Padimo/bioimpedance/pcb.jpg

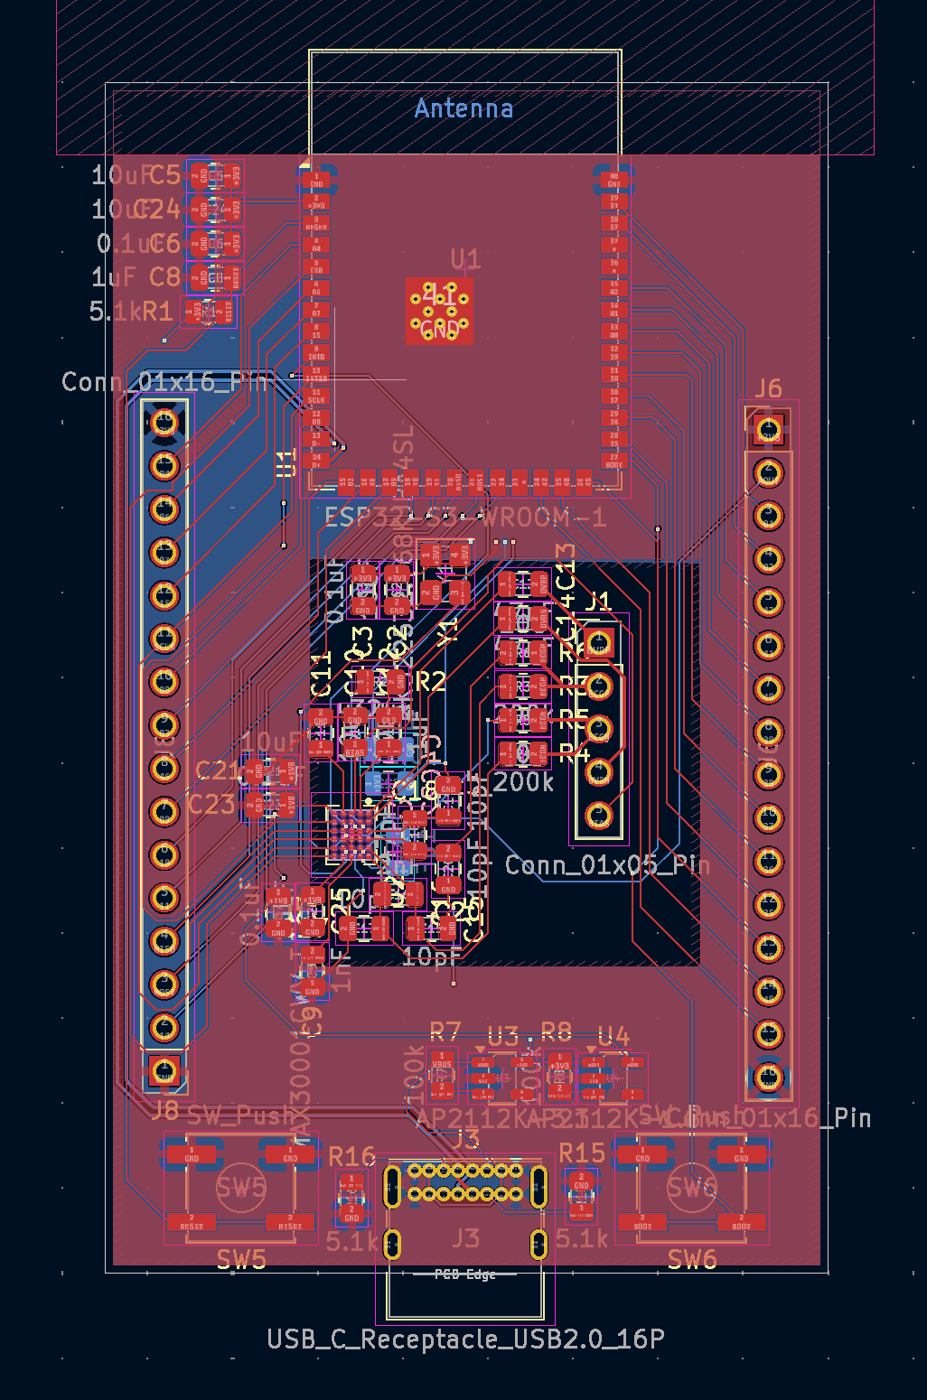
pcb.jpg
