Padimo/bioimpedance/rend1.jpg

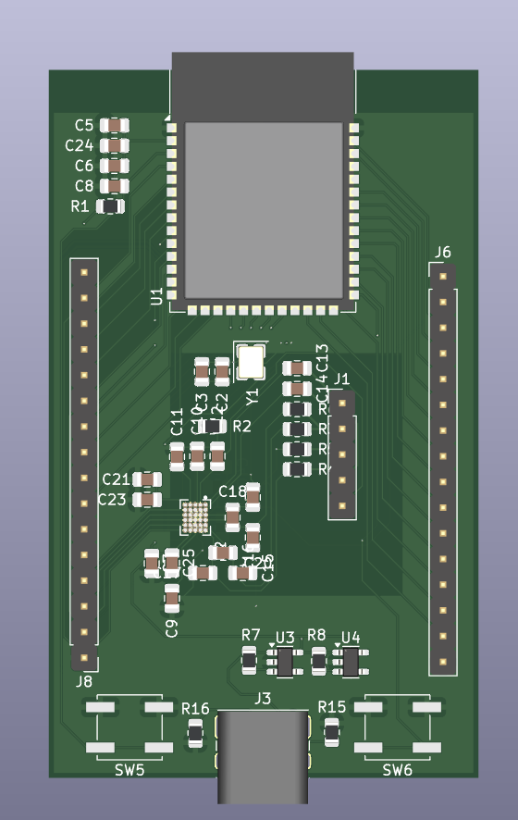
rend1.jpg
