Padimo/bioimpedance/rend1.png

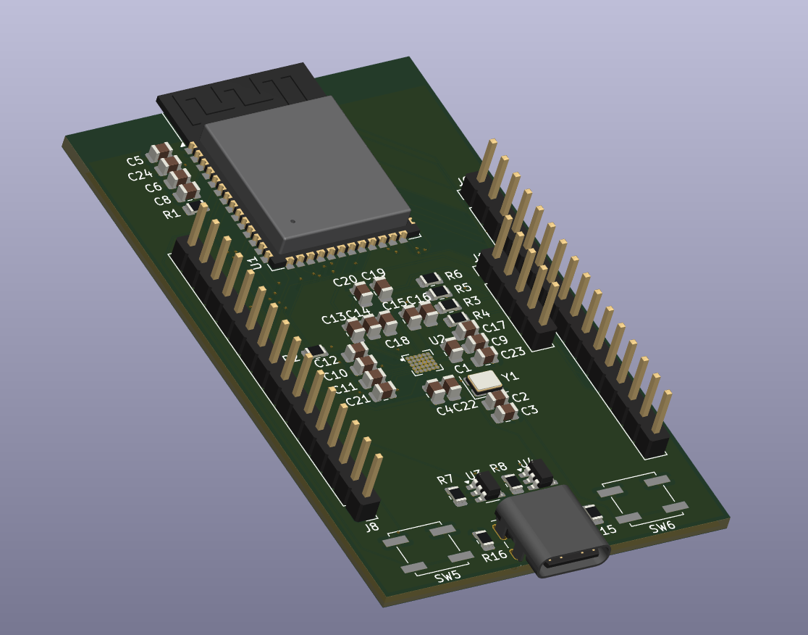
rend1.png
