Padimo/bioimpedance/rend2.jpg

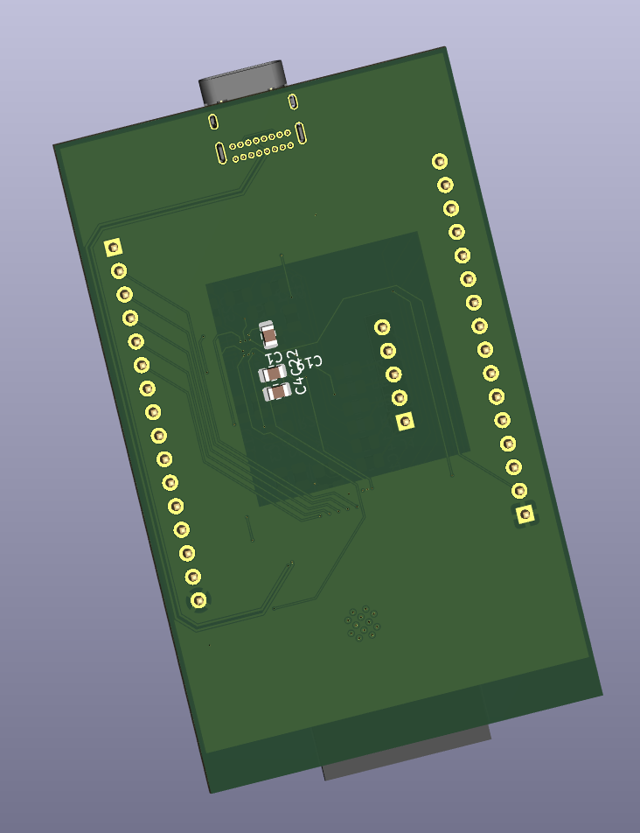
rend2.jpg
