Padimo/bioimpedance/production/JLC_BOM.xlsx

Comment | Designator | Footprint | JLCPCB Part #（optional）
ESPRESSIF ESP32-S3-WROOM-1-N8 | U1 | ESP32-S3-WROOM-1 | C2913199
USB C | J3 | USB_C_Receptacle_GCT_USB4085 | C7095263
Push button | SW5,SW6 | SW_Push_1P1T_NO_CK_KSC6xxJ | C2888743
Oscillator 32kHz | Y1 | Crystal_SMD_3225_4Pin_3.2x2.5mm | C725996
MAX30001 | U2 | BGA30N50P5X6_274X292X69N | C2650384
1.8V regulator | U4 | SOT-25-5 | C176944
3.3V regulator | U3 | SOT-25-5 | C51118
10uF | C2,C4,C5,C10,C11,C21,C24,C25 |  | C1713
1uF | C1,C8,C12 |  | C1712
0.1uF | C3,C6,C7,C22,C23 |  | C1711
1nF | C9 |  | C46653
47nF | C13,C14 |  | C1744
2nF | C16 |  | C28260
47pF | C18 |  | C14857
10pF | C15,C17,C19,C20 |  | C107107
5.1k | R1,R15,R16 |  | C27834
324k | R2 |  | C17626
200k | R3,R4 |  | C17539
200 | R5,R6 |  | C17540
100k | R7,R8 |  | C25611
