Padimo/bioimpedance/(list of files, drawings)

Other design files:
pcb/freerouting.dsn
pcb/temp-freerouting.dsn
