Padimo/bioimpedance/pcb/bioimpedance.kicad_pcb

## KiCad design pcb/bioimpedance.kicad_pcb (2025-08-21)

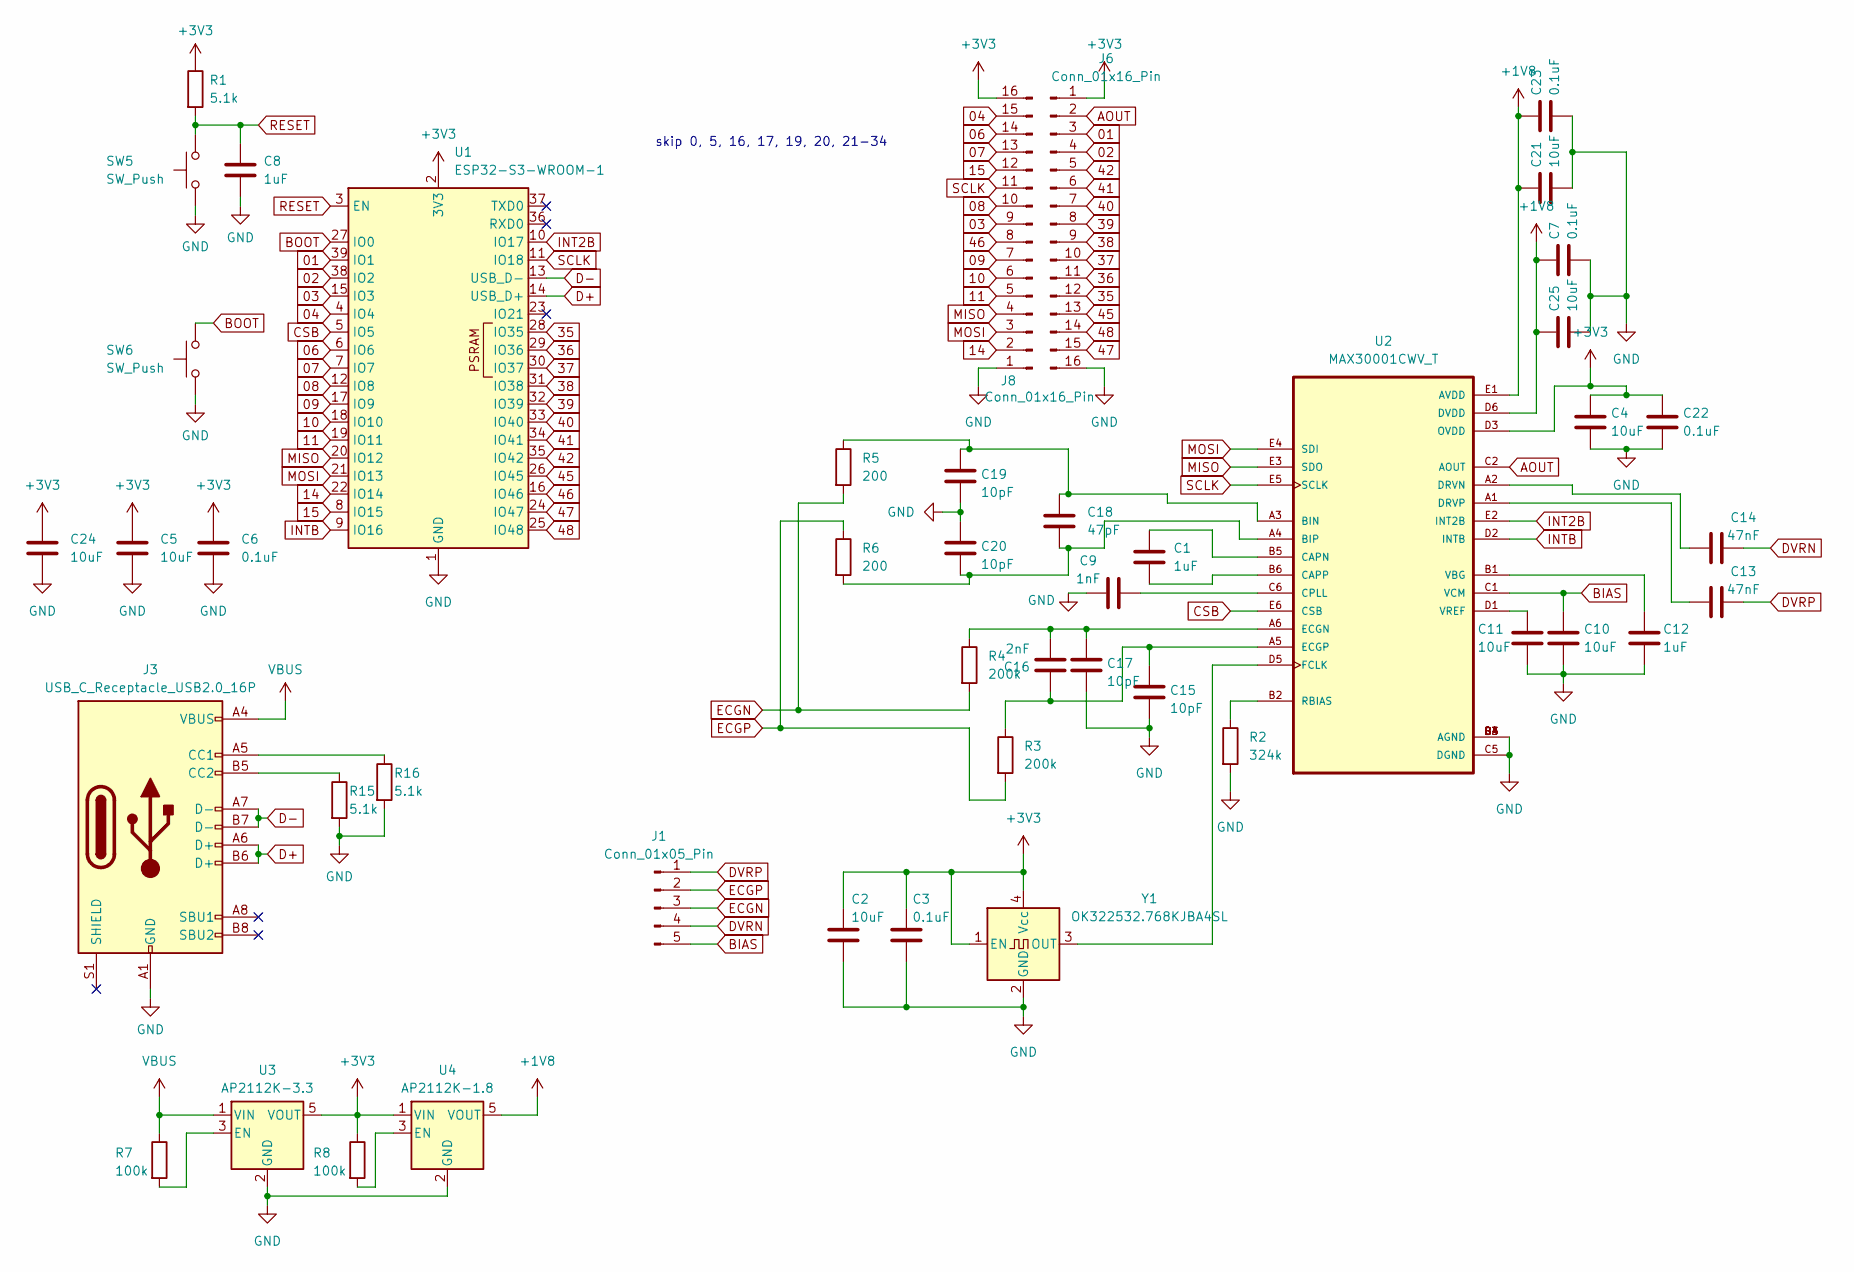
[picture p12: schematic bioimpedance.kicad_sch]

Parts:
C1, C8, C12: 1uF; C_0805_2012Metric
C2, C4, C5, C10, C11, C21, C24, C25: 10uF; C_0805_2012Metric
C3, C6, C7, C22, C23: 0.1uF; C_0805_2012Metric
C9: 1nF; C_0805_2012Metric
C13, C14: 47nF; C_0805_2012Metric
C15, C17, C19, C20: 10pF; C_0805_2012Metric
C16: 2nF; C_0805_2012Metric
C18: 47pF; C_0805_2012Metric
J1: Conn_01x05_Pin; PinHeader_1x05_P2.54mm_Vertical
J3: USB_C_Receptacle_USB2.0_16P; USB_C_Receptacle_GCT_USB4085
J6, J8: Conn_01x16_Pin; PinHeader_1x16_P2.54mm_Vertical
R1, R15, R16: 5.1k; R_0805_2012Metric
R2: 324k; R_0805_2012Metric
R3, R4: 200k; R_0805_2012Metric
R5, R6: 200; R_0805_2012Metric
R7, R8: 100k; R_0805_2012Metric
SW5, SW6: SW_Push; SW_Push_1P1T_NO_CK_KSC6xxJ
U1: ESP32-S3-WROOM-1
U2: MAX30001CWV_T; BGA30N50P5X6_274X292X69N
U3: AP2112K-3.3; SOT-23-5
U4: AP2112K-1.8; SOT-23-5
Y1: OK322532.768KJBA4SL; Crystal_SMD_3225-4Pin_3.2x2.5mm

Connections:
01: J6.3, U1.39 (IO1)
02: J6.4, U1.38 (IO2)
03: J8.9, U1.15 (IO3)
04: J8.15, U1.4 (IO4)
06: J8.14, U1.6 (IO6)
07: J8.13, U1.7 (IO7)
08: J8.10, U1.12 (IO8)
09: J8.7, U1.17 (IO9)
10: J8.6, U1.18 (IO10)
11: J8.5, U1.19 (IO11)
14: J8.2, U1.22 (IO14)
15: J8.12, U1.8 (IO15)
35: J6.12, U1.28 (IO35)
36: J6.11, U1.29 (IO36)
37: J6.10, U1.30 (IO37)
38: J6.9, U1.31 (IO38)
39: J6.8, U1.32 (IO39)
40: J6.7, U1.33 (IO40)
41: J6.6, U1.34 (IO41)
42: J6.5, U1.35 (IO42)
45: J6.13, U1.26 (IO45)
46: J8.8, U1.16 (IO46)
47: J6.15, U1.24 (IO47)
48: J6.14, U1.25 (IO48)
+1V8: C7.1, C21.1, C23.1, C25.1, U2.D6 (DVDD), U2.E1 (AVDD), U4.5 (VOUT)
+3V3: C2.1, C3.1, C4.1, C5.1, C6.1, C22.1, C24.1, J6.1, J8.16, R1.1, R8.1, U1.2 (3V3), U2.D3 (OVDD), U3.5 (VOUT), U4.1 (VIN), Y1.1 (EN), Y1.4 (Vcc)
AOUT: J6.2, U2.C2 (AOUT)
BIAS: C10.1, J1.5, U2.C1 (VCM)
BOOT: SW6.2, U1.27 (IO0)
CSB: U1.5 (IO5), U2.E6 (CSB)
D+: J3.A6 (D+), J3.B6 (D+), U1.14 (USB_D+)
D-: J3.A7 (D-), J3.B7 (D-), U1.13 (USB_D-)
DVRN: C14.2, J1.4
DVRP: C13.2, J1.1
ECGN: J1.3, R4.2, R5.2
ECGP: J1.2, R3.2, R6.1
GND: C2.2, C3.2, C4.2, C5.2, C6.2, C7.2, C8.2, C9.1, C10.2, C11.2, C12.2, C15.2, C17.2, C19.2, C20.1, C21.2, C22.2, C23.2, C24.2, C25.2, J3.A1 (GND), J3.A12 (GND), J3.B1 (GND), J3.B12 (GND), J6.16, J8.1, R2.2, R15.2, R16.2, SW5.1, SW6.1, U1.1 (GND), U1.40 (GND), U1.41 (GND), U2.B3 (AGND), U2.B4 (AGND), U2.C3 (AGND), U2.C4 (AGND), U2.C5 (DGND), U2.D4 (AGND), U3.2 (GND), U4.2 (GND), Y1.2 (GND)
INT2B: U1.10 (IO17), U2.E2 (INT2B)
INTB: U1.9 (IO16), U2.D2 (INTB)
MISO: J8.4, U1.20 (IO12), U2.E3 (SDO)
MOSI: J8.3, U1.21 (IO13), U2.E4 (SDI)
unnamed: J3.A5 (CC1), R16.1
unnamed: J3.B5 (CC2), R15.1
unnamed: C18.1, C19.1, R5.1, U2.A3 (BIN)
unnamed: C18.2, C20.2, R6.2, U2.A4 (BIP)
unnamed: C1.1, U2.B5 (CAPN)
unnamed: C1.2, U2.B6 (CAPP)
unnamed: C9.2, U2.C6 (CPLL)
unnamed: C14.1, U2.A2 (DRVN)
unnamed: C13.1, U2.A1 (DRVP)
unnamed: C16.2, C17.1, R4.1, U2.A6 (ECGN)
unnamed: C15.1, C16.1, R3.1, U2.A5 (ECGP)
unnamed: U2.D5 (FCLK), Y1.3 (OUT)
unnamed: R2.1, U2.B2 (RBIAS)
unnamed: C12.1, U2.B1 (VBG)
unnamed: C11.1, U2.D1 (VREF)
unnamed: R7.2, U3.3 (EN)
unnamed: R8.2, U4.3 (EN)
RESET: C8.1, R1.2, SW5.2, U1.3 (EN)
SCLK: J8.11, U1.11 (IO18), U2.E5 (SCLK)
VBUS: J3.A4 (VBUS), J3.A9 (VBUS), J3.B4 (VBUS), J3.B9 (VBUS), R7.1, U3.1 (VIN)

Notes on the sheet:
skip 0, 5, 16, 17, 19, 20, 21-34

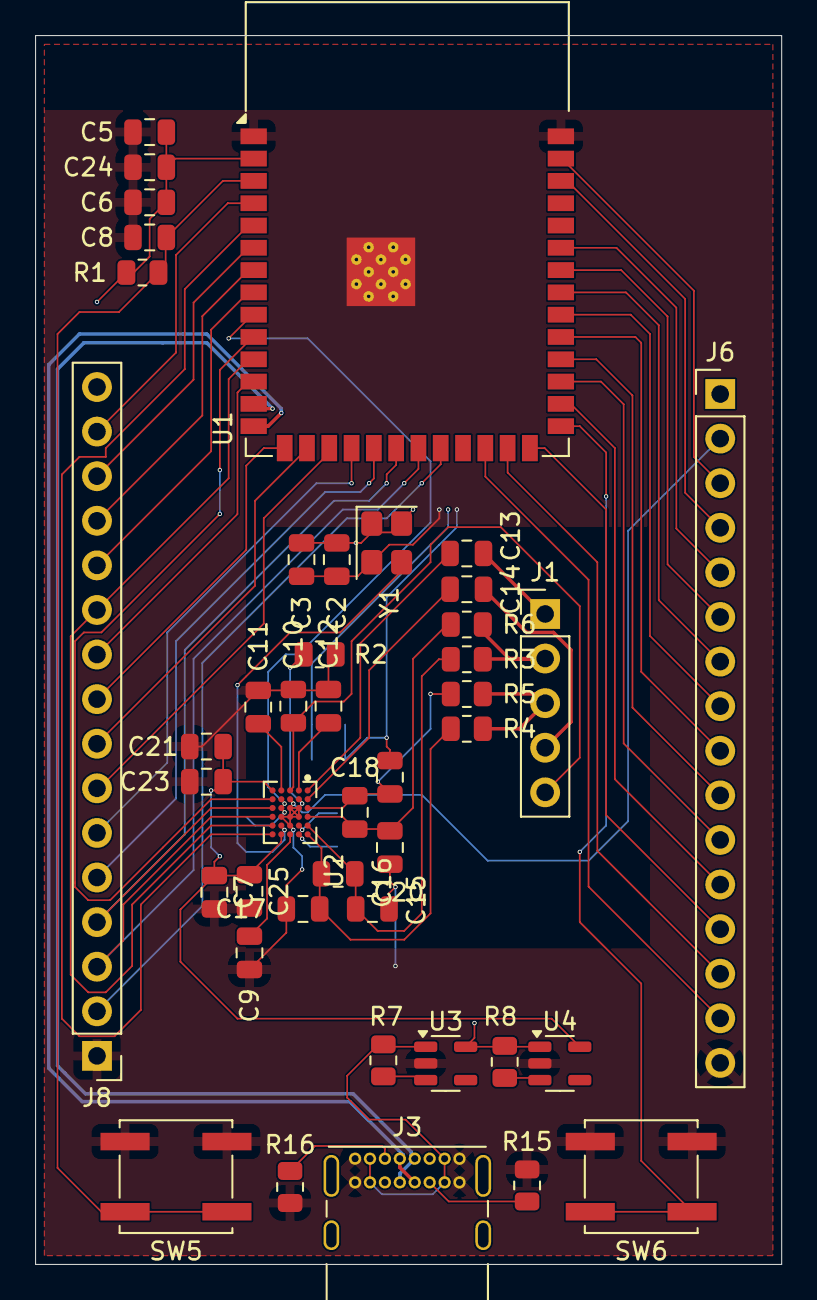
[picture p13: board bioimpedance.kicad_pcb from above]

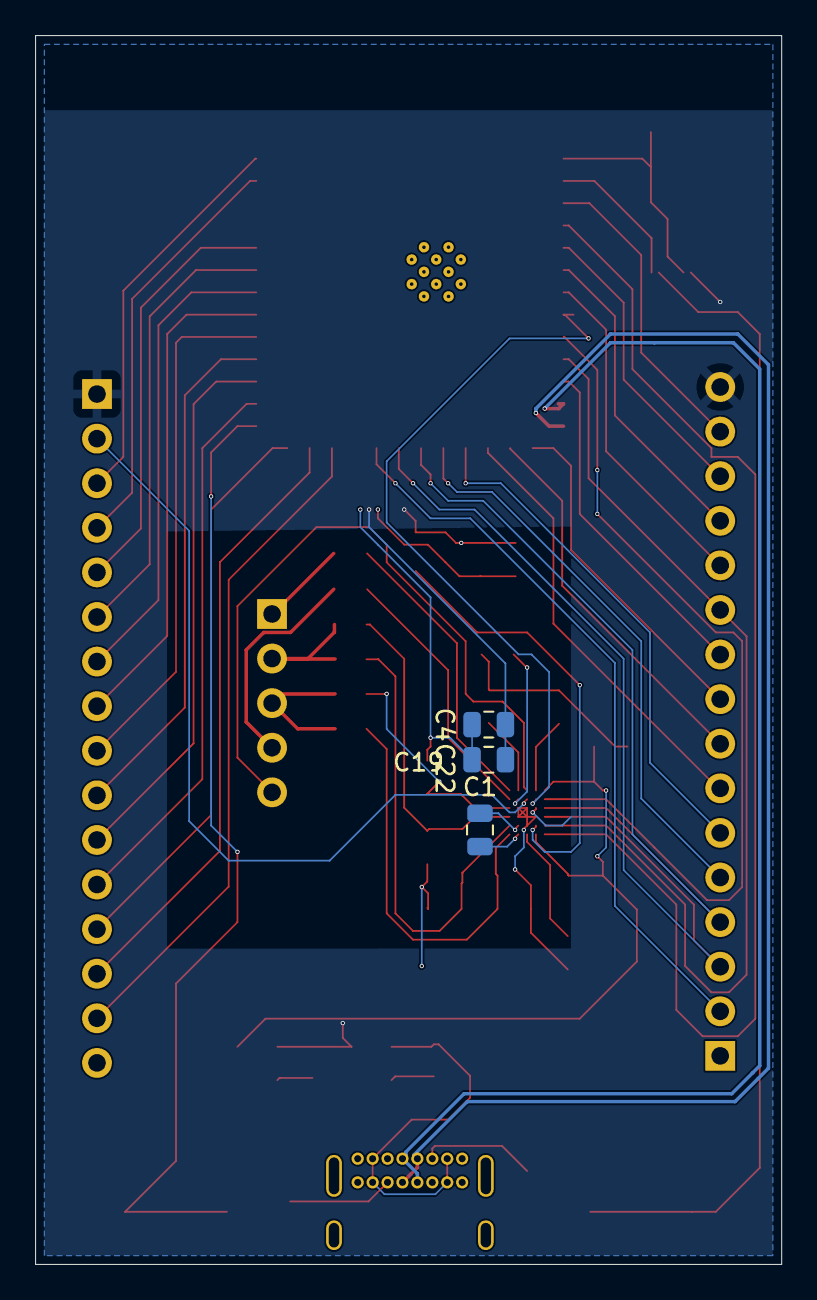
[picture p14: board bioimpedance.kicad_pcb from below]

Board: 2 copper layers, 42.5 x 70.0 mm, 46 parts (3 on the bottom side), 61 nets.
