Padimo/bioimpedance/(commit log)

2025-08-18 reroute pcb
    [bioimpedance.kicad_pcb]
2025-08-18 reroute pcb AGAIN
    [bioimpedance-B_Cu.gbr, bioimpedance-B_Mask.gbr, bioimpedance-B_Paste.gbr, bioimpedance-B_Silkscreen.gbr, bioimpedance-Edge_Cuts.gbr, bioimpedance-F_Cu.gbr, bioimpedance-F_Mask.gbr, bioimpedance-F_Paste.gbr]
2025-08-20 reroute board. again
    [bioimpedance-B_Cu.gbr, bioimpedance-B_Mask.gbr, bioimpedance-B_Paste.gbr, bioimpedance-B_Silkscreen.gbr, bioimpedance-Edge_Cuts.gbr, bioimpedance-F_Cu.gbr, bioimpedance-F_Mask.gbr, bioimpedance-F_Paste.gbr]
2025-08-21 reroute board. again. removed copper near measurement traces
    [bioimpedance-B_Cu.gbr, bioimpedance-B_Mask.gbr, bioimpedance-B_Paste.gbr, bioimpedance-B_Silkscreen.gbr, bioimpedance-Edge_Cuts.gbr, bioimpedance-F_Cu.gbr, bioimpedance-F_Mask.gbr, bioimpedance-F_Paste.gbr]
2025-11-13 Push all changes
    [JLC_BOM.xlsx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]
